DrJuanchi/Innovative-Temperature-Sensing-PCB-Design-and-Data-Collection/Test.ino

const byte led_gpio = 35;

// the setup function runs once when you press reset or power the board
void setup() {
  // initialize digital pin LED_BUILTIN as an output.
  pinMode(led_gpio, OUTPUT);
}

// the loop function runs over and over again forever
void loop() {
  digitalWrite(led_gpio, HIGH);   // turn the LED on (HIGH is the voltage level)
  delay(1000);                       // wait for a second
  digitalWrite(led_gpio, LOW);    // turn the LED off by making the voltage LOW
  delay(1000);                       // wait for a second
}
